DRogla17/Dimitrije_repos_TSAL/README.md

# Dimitrije_repos_TSAL
Repository made for TSAL part of Formula Student vehicle for Black Hornets Formula Student Team from Faculty of Technical Sciences, Novi Sad.
