DRogla17/Dimitrije_repos_TSAL/4_TSALCircuit.kicad_pcb

## KiCad design 4_TSALCircuit.kicad_pcb (2026-04-28)

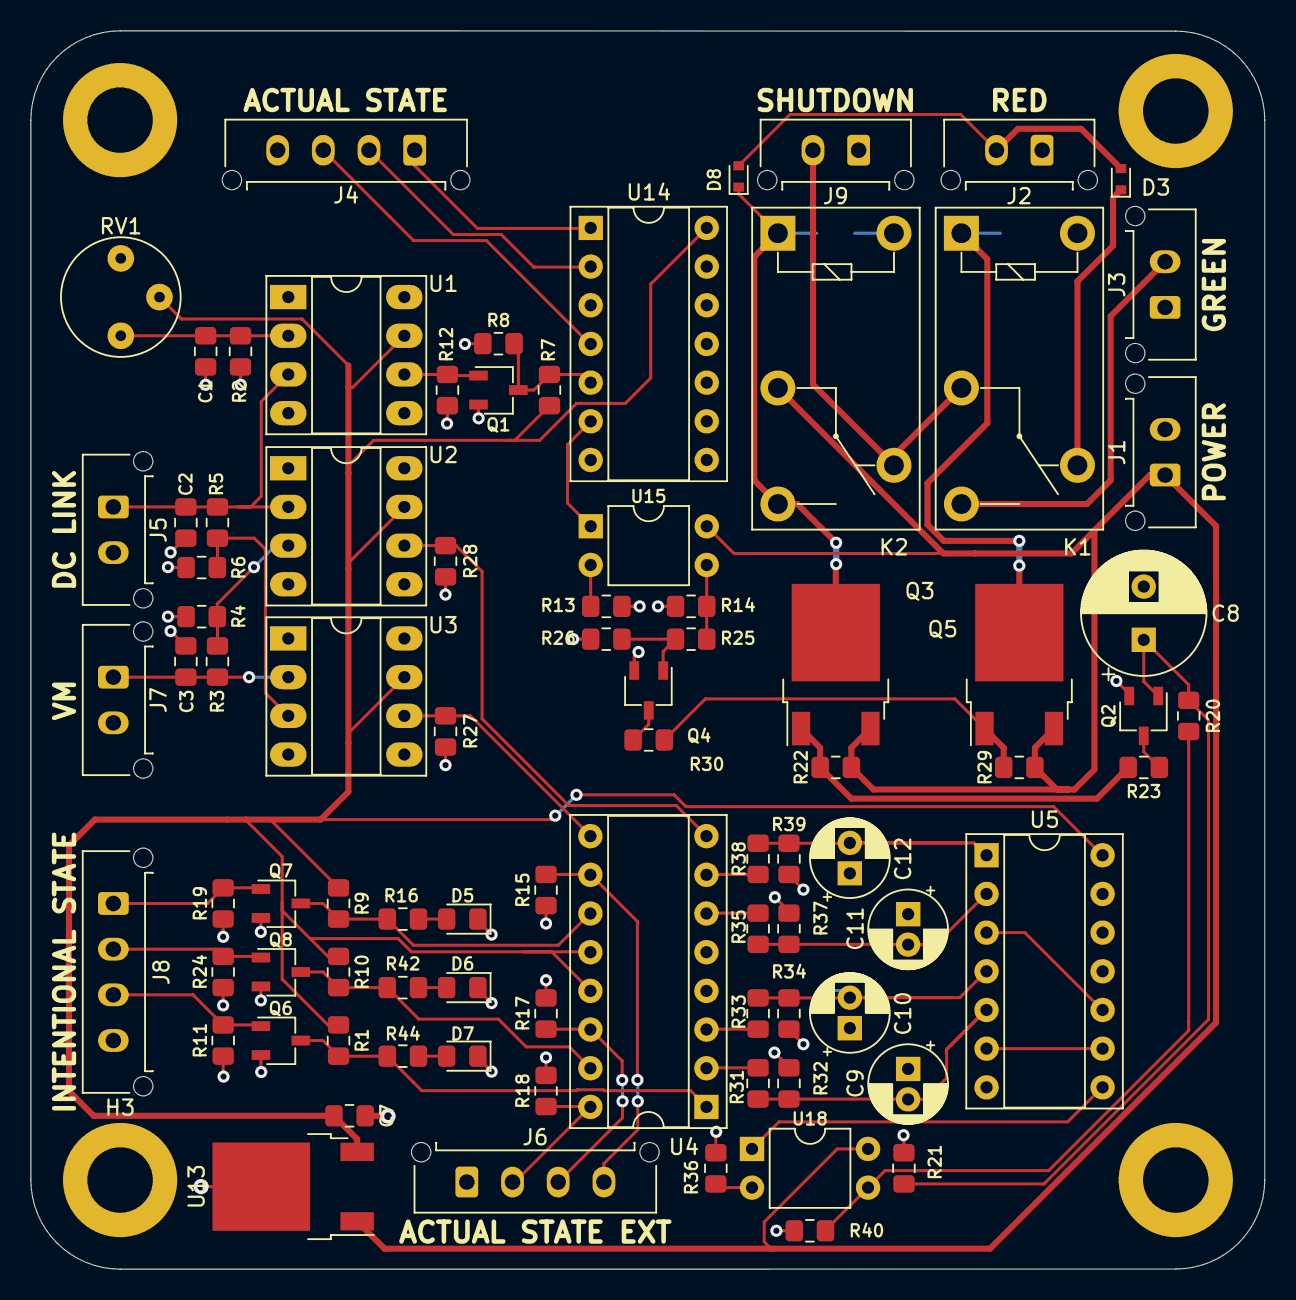
[picture p6: board 4_TSALCircuit.kicad_pcb from above]

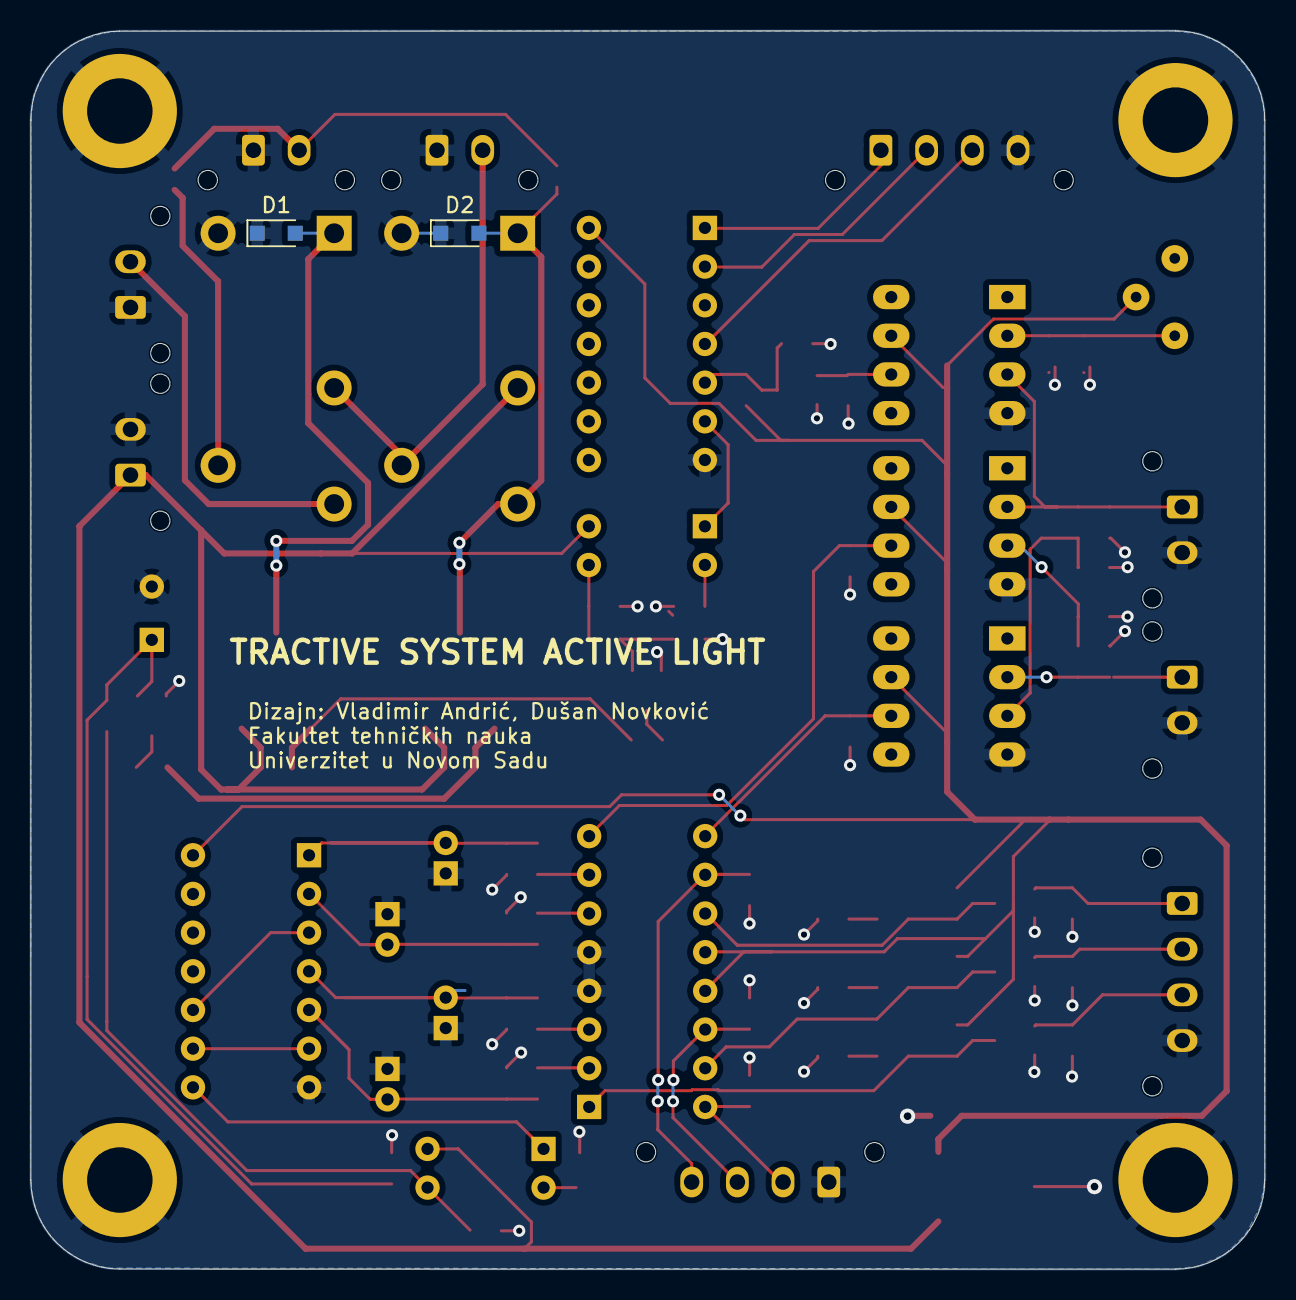
[picture p7: board 4_TSALCircuit.kicad_pcb from below]

Board: 2 copper layers, 81.0 x 81.3 mm, 91 parts (2 on the bottom side), 55 nets.

Parts:
C1, C2, C3: 10nF; C_0805_2012Metric_Pad1.15x1.40mm_HandSolder
C7: 100n; C_0805_2012Metric_Pad1.15x1.40mm_HandSolder
C8: 340u; CP_Radial_D8.0mm_P3.50mm
C9, C10, C11, C12: 10u; CP_Radial_D5.0mm_P2.00mm
D1, D2: DIODE; D_SOD-323_HandSoldering
D3, D8: DIODE; D_SOD-523
D5, D6, D7: LED; LED_0805_2012Metric_Pad1.15x1.40mm_HandSolder
H1, H2, H3, H4: MountingHole_Pad; MountingHole_4.3mm_M4_DIN965_Pad
J1: Power; Molex_Micro-Fit_3.0_43650-0215_1x02_P3.00mm_Vertical
J2: Red Light; Molex_Micro-Fit_3.0_43650-0215_1x02_P3.00mm_Vertical
J3: Green Light; Molex_Micro-Fit_3.0_43650-0215_1x02_P3.00mm_Vertical
J4, J6: Actual State; Molex_Micro-Fit_3.0_43650-0415_1x04_P3.00mm_Vertical
J5: VM DC Link Capacitor; Molex_Micro-Fit_3.0_43650-0215_1x02_P3.00mm_Vertical
J7: VM TSAC; Molex_Micro-Fit_3.0_43650-0215_1x02_P3.00mm_Vertical
J8: Intentional State; Molex_Micro-Fit_3.0_43650-0415_1x04_P3.00mm_Vertical
J9: Error_to_SHD; Molex_Micro-Fit_3.0_43650-0215_1x02_P3.00mm_Vertical
K1, K2: G5Q-1; Relay_SPDT_Omron-G5Q-1
Q1, Q2, Q4, Q6, Q7, Q8: Q_NMOS_GDS; TSOT-23
Q3, Q5: PMOS; TO-252-2
R1, R3, R5, R8, R9, R10, R11, R14, R15, R17, R18, R19, R22, R24, R27, R28, R29, R40: 10k; R_0805_2012Metric_Pad1.15x1.40mm_HandSolder
R2, R20: 5k; R_0805_2012Metric_Pad1.15x1.40mm_HandSolder
R4, R6: 47k; R_0805_2012Metric_Pad1.15x1.40mm_HandSolder
R7, R12, R13, R16, R23, R30, R31, R33, R35, R36, R38, R42, R44: 1k; R_0805_2012Metric_Pad1.15x1.40mm_HandSolder
R21, R26, R32, R34, R37, R39: 100k; R_0805_2012Metric_Pad1.15x1.40mm_HandSolder
R25: 34k; R_0805_2012Metric_Pad1.15x1.40mm_HandSolder
RV1: R_POT; Potentiometer_Bourns_3339P_Vertical_HandSoldering
U1, U2, U3: MCP6541; DIP-8_W7.62mm_Socket_LongPads
U4: 74AC11086; DIP-16_W7.62mm_Socket
U5: SN74LVC32AD; DIP-14_W7.62mm_Socket
U13: NCV7805BDTRKG; TO-252-2
U14: SN74HC21NX; DIP-14_W7.62mm_Socket
U15, U18: SFH617A-1; DIP-4_W7.62mm

Connections:
+5V: C7.1, R1.1, R7.1, R9.1, R10.1, RV1.2, U1.7, U2.7, U3.7, U4.12, U4.13, U5.14, U13.3, U14.14
+12V: J1.1, K2.2, Q3.3, Q5.3, R22.1, R29.1, U13.1, U15.4, U18.4
/Act_State_1: J4.1, U14.1
/Act_State_2: J4.2, U14.2
/Act_State_3: J4.3, U14.4
/Act_State_Ext_1: J6.4, R15.1, U4.10
/Act_State_Ext_2: J6.3, R17.1, U4.14
/Act_State_Ext_3: J6.2, R18.1, U4.16
/Error_Shutdown: J9.2, K1.2, K2.4
/GreenLight_ON: R14.1, R25.1, U15.3
/Green_Light: J3.2, K1.3
/Int_Out_1: Q7.3, R9.2, R16.1, U4.11
/Int_Out_2: Q8.3, R10.2, R42.1, U4.15
/Int_Out_3: Q6.3, R1.2, R44.1, U4.1
/Int_State_1: J8.1, Q7.1, R19.1
/Int_State_2: J8.2, Q8.1, R24.1
/Int_State_3: J8.3, Q6.1, R11.1
/RedLight_LATCHED: R20.1, R40.1, U18.3
/Red_Light: D3.2, D8.2, J2.2
/VM_DC_Link: C2.1, J5.1, R5.1, U1.3, U2.2
/VM_TSAC: C3.1, J7.1, R3.1, U3.2
GND: C1.2, C2.2, C3.2, C7.2, C8.2, C9.1, C10.1, C11.1, C12.1, D1.1, D2.1, D5.1, D6.1, D7.1, H1.1, H2.1, H3.1, H4.1, J1.2, J2.1, J3.1, J4.4, J5.2, J6.1, J7.2, J8.4, J9.1, K1.5, K2.5, Q1.2, Q2.2, Q4.2, Q6.2, Q7.2, Q8.2, R2.2, R4.2, R6.2, R8.2, R11.2, R12.2, R13.2, R14.2, R15.2, R17.2, R18.2, R19.2, R21.1, R24.2, R26.1, R27.2, R28.2, R32.2, R34.2, R36.2, R37.2, R39.2, R40.2, U1.4, U2.4, U3.4, U4.4, U4.5, U5.7, U13.2, U14.7
unnamed: C1.1, R2.1, RV1.3, U1.2
unnamed: C8.1, Q2.1, R20.2, R21.2
unnamed: C9.2, R31.1, R32.1, U5.5
unnamed: C10.2, R33.1, R34.1, U5.4
unnamed: C11.2, R35.1, R37.1, U5.2
unnamed: C12.2, R38.1, R39.1, U5.1
unnamed: D1.2, K1.1, Q5.2
unnamed: D2.2, D8.1, K2.1, K2.3, Q3.2
unnamed: D3.1, K1.4
unnamed: D5.2, R16.2
unnamed: D6.2, R42.2
unnamed: D7.2, R44.2
unnamed: Q1.1, R12.1, U1.6
unnamed: Q1.3, R7.2, R8.1, U14.5
unnamed: Q2.3, R23.2
unnamed: Q3.1, R22.2, R23.1
unnamed: Q4.1, R25.2, R26.2
unnamed: Q4.3, R30.2
unnamed: Q5.1, R29.2, R30.1
unnamed: R3.2, R4.1, U2.3
unnamed: R5.2, R6.1, U3.3
unnamed: R13.1, U15.2
unnamed: R27.1, U3.6, U4.9
unnamed: R28.1, U2.6, U4.8
unnamed: R31.2, U4.2
unnamed: R33.2, U4.3
unnamed: R35.2, U4.6
unnamed: R36.1, U18.2
unnamed: R38.2, U4.7
unnamed: U5.6, U5.9
unnamed: U5.3, U5.10
unnamed: U14.6, U15.1
unnamed: U5.8, U18.1
